Hani256/pressure-control-rig/pressure_control_rig.ioc

Mcu.UserName=STM32F411CEUx
PA0-WKUP.Signal=GPXTI0
PA13.Signal=SYS_JTMS-SWDIO
PA14.Signal=SYS_JTCK-SWCLK
PA2.Signal=USART2_TX
PA3.Signal=USART2_RX
PA5.Signal=S_TIM2_CH1_ETR
PA8.Signal=S_TIM1_CH1
PB0.Signal=GPIO_Output
PB1.Signal=GPIO_Output
PB6.Signal=I2C1_SCL
PB7.Signal=I2C1_SDA
PC13-ANTI_TAMP.Signal=GPIO_Output
